AdibTantowi/AgroSense/File firmware/training_data.h

#ifndef TRAINING_DATA_H
#define TRAINING_DATA_H

// ============================================================
// AgroSense - Data Training KNN (600 sampel, 5 kelas tanaman)
// Disimpan di PROGMEM (flash), dibaca satu-per-satu via memcpy_P
// agar hemat RAM ESP32-S3.
//
// Format per baris: {classID, N, P, K, pH*10, moisture}
// classID: 0=Bawang Merah, 1=Jagung, 2=Kangkung, 3=Kol, 4=Padi
//
// PENTING: struct TrainingData dan #define JUMLAH_DATA harus
// sudah dideklarasikan di file .ino SEBELUM baris
// #include "training_data.h" ini.
// ============================================================

const TrainingData trainingSet[JUMLAH_DATA] PROGMEM = {
  // Bawang Merah (0) - classID = 0
  {0, 54, 23, 44, 53, 49},
  {0, 62, 27, 51, 52, 49},
  {0, 56, 24, 46, 57, 52},
  {0, 64, 28, 53, 45, 53},
  {0, 54, 24, 45, 57, 54},
  {0, 51, 22, 42, 55, 50},
  {0, 54, 23, 44, 55, 49},
  {0, 58, 25, 48, 48, 86},
  {0, 58, 25, 48, 53, 48},
  {0, 51, 22, 42, 52, 49},
  {0, 60, 26, 50, 53, 49},
  {0, 58, 25, 47, 42, 50},
  {0, 54, 23, 44, 51, 87},
  {0, 61, 26, 50, 51, 52},
  {0, 61, 27, 51, 51, 50},
  {0, 62, 27, 51, 48, 50},
  {0, 53, 23, 43, 49, 51},
  {0, 52, 22, 42, 48, 56},
  {0, 61, 27, 51, 49, 52},
  {0, 56, 24, 46, 49, 53},
  {0, 54, 23, 44, 52, 56},
  {0, 49, 21, 40, 44, 41},
  {0, 62, 27, 51, 48, 54},
  {0, 67, 29, 55, 55, 64},
  {0, 76, 33, 63, 44, 44},
  {0, 52, 23, 43, 55, 60},
  {0, 52, 23, 43, 52, 84},
  {0, 57, 24, 46, 45, 51},
  {0, 57, 25, 47, 48, 69},
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
  {4, 68, 30, 57, 76, 73},
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
  // Tambahan
  {4, 85, 37, 71, 73, 98},
  {4, 67, 28, 55, 74, 76},
  {4, 71, 31, 59, 73, 99},
  {4, 73, 32, 60, 73, 94},
  {4, 71, 31, 59, 70, 94},
  {4, 64, 29, 53, 70, 94},
  {4, 70, 31, 57, 70, 78},
  {4, 58, 25, 48, 74, 61}
};

#endif // TRAINING_DATA_H
