AdibTantowi/AgroSense/(notices)

Notices in the files:
readme.md:
License: MIT
